DavidMFlynn/RotarySwitch/README.md

# RotarySwitch
 Electronic Rotary Switch
