DavidMFlynn/RotarySwitch/scad/R-SwitchExpanded.png

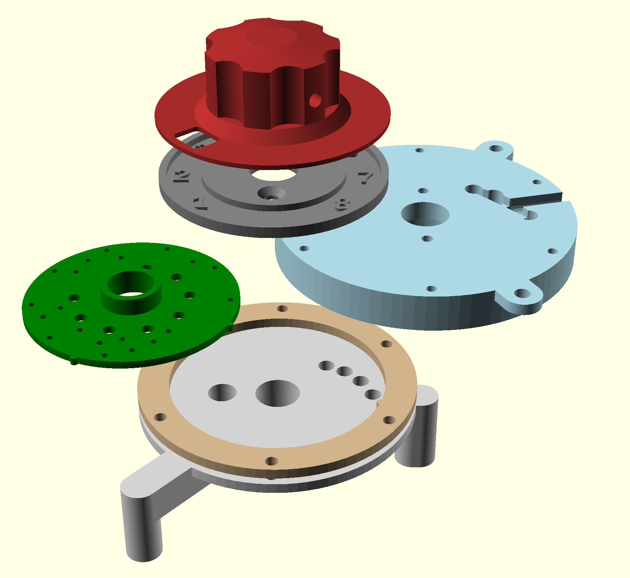
scad/R-SwitchExpanded.png
