DavidMFlynn/RotarySwitch/scad/STL/CW14/RS_Spacer.stl

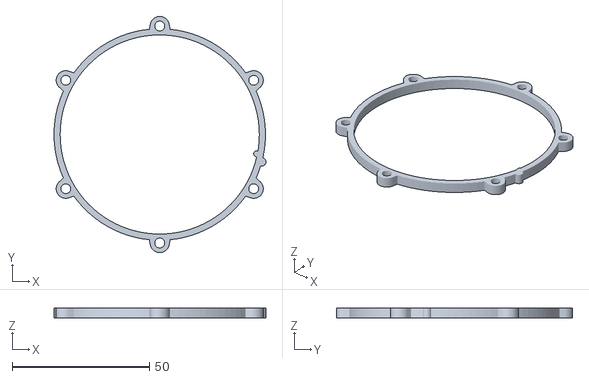
[picture p2: CAD file, 2019-12-07]
scad/STL/CW14/RS_Spacer.stl
77.2 x 86.0 x 3.67
