DavidMFlynn/RotarySwitch/scad/STL/CW16/CW16.stl

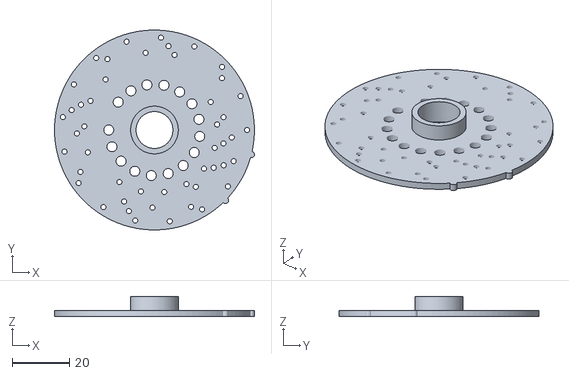
[picture p3: CAD file, 2019-12-07]
scad/STL/CW16/CW16.stl
70.0 x 70.0 x 7.10
