DavidMFlynn/RotarySwitch/scad/STL/n10/CodeWheel.stl

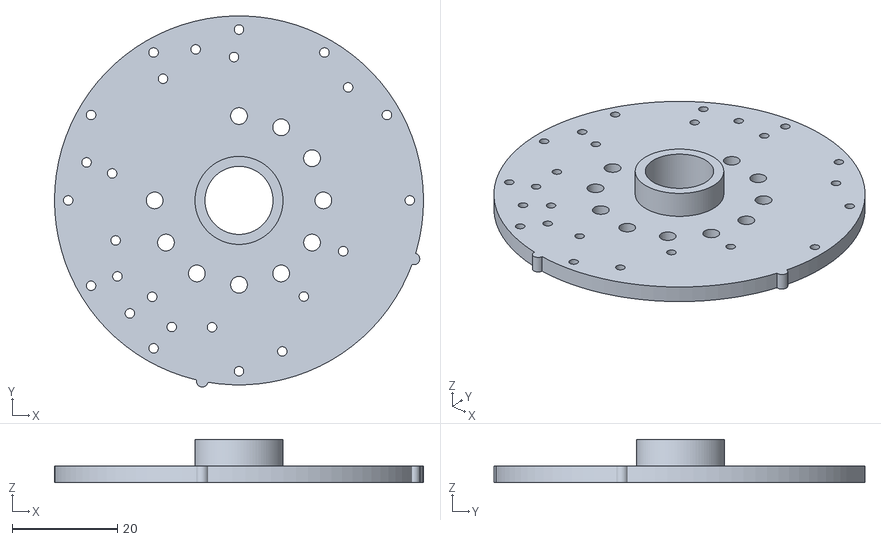
[picture p4: CAD file, 2021-05-18]
scad/STL/n10/CodeWheel.stl
70.0 x 70.4 x 8.17
