DavidMFlynn/RotarySwitch/scad/STL/n4/SpringCover.stl

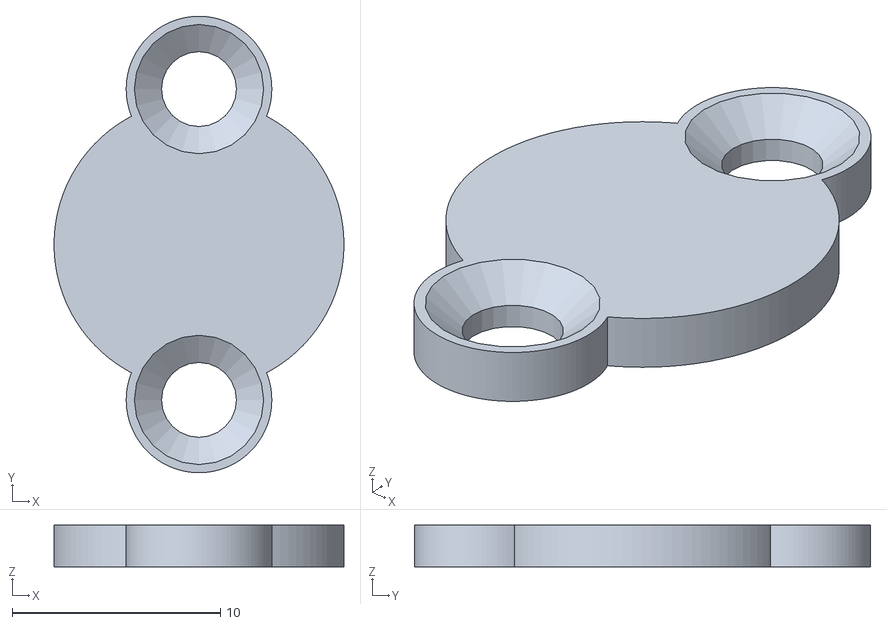
[picture p5: CAD file, 2021-05-18]
scad/STL/n4/SpringCover.stl
13.9 x 21.9 x 2.00
