DavidMFlynn/RotarySwitch/scad/STL/n7/KnobNS.stl

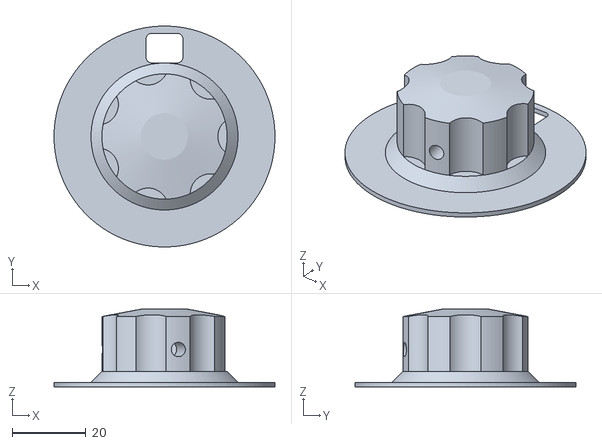
[picture p6: CAD file, 2021-05-18]
scad/STL/n7/KnobNS.stl
60.0 x 60.0 x 21.1
