DavidMFlynn/RotarySwitch/scad/STL/n9/KnobNS.stl

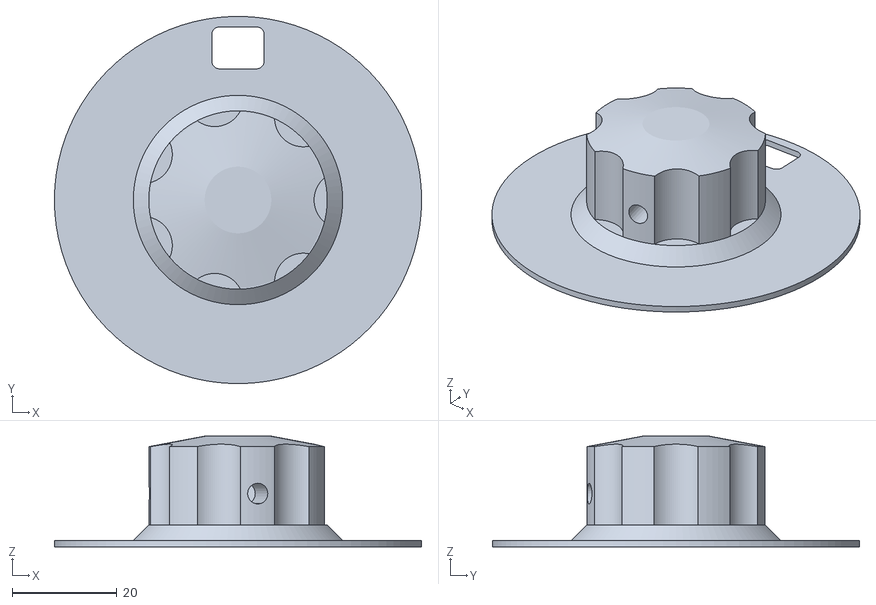
[picture p7: CAD file, 2021-05-18]
scad/STL/n9/KnobNS.stl
70.0 x 70.0 x 21.1
