DavidMFlynn/RotarySwitch/scad/STL/CW16/BotPlate.stl

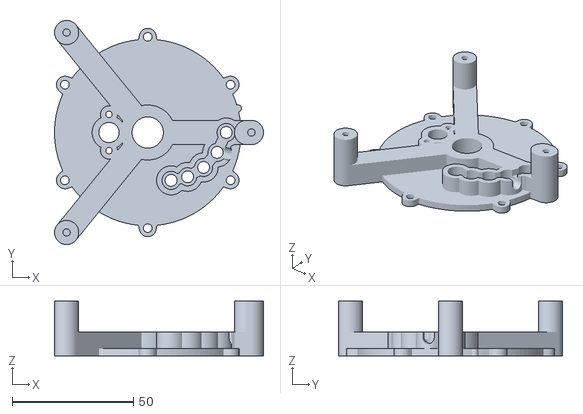
[picture p8: CAD file, 2019-08-11]
scad/STL/CW16/BotPlate.stl
86.3 x 92.5 x 22.7
