DavidMFlynn/RotarySwitch/scad/STL/n10/NumberPlate.stl

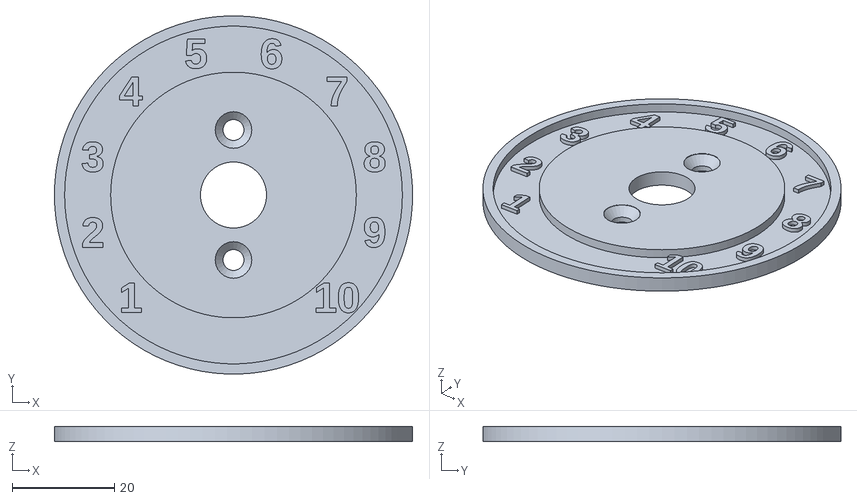
[picture p9: CAD file, 2021-05-18]
scad/STL/n10/NumberPlate.stl
70.0 x 70.0 x 3.00
