DavidMFlynn/RotarySwitch/scad/STL/n4/BotPlate.stl

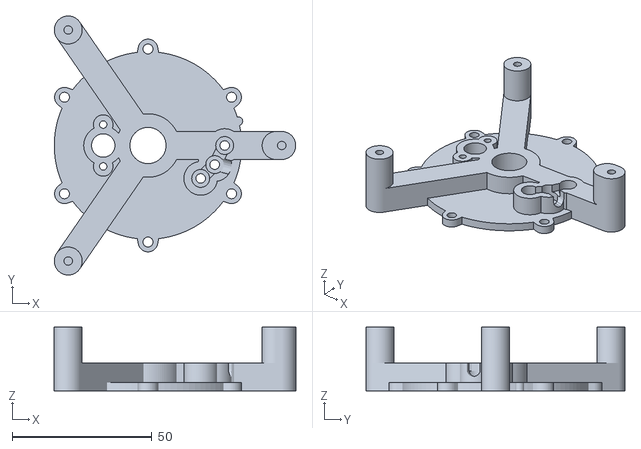
[picture p10: CAD file, 2021-05-18]
scad/STL/n4/BotPlate.stl
86.3 x 92.5 x 22.7
