DavidMFlynn/RotarySwitch/scad/STL/n7/NumberPlate77.stl

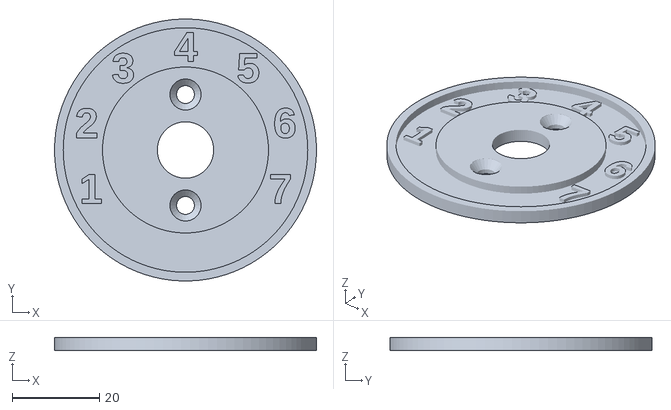
[picture p11: CAD file, 2021-05-18]
scad/STL/n7/NumberPlate77.stl
60.0 x 60.0 x 3.00
