DavidMFlynn/RotarySwitch/scad/STL/n10/TopPlate.stl

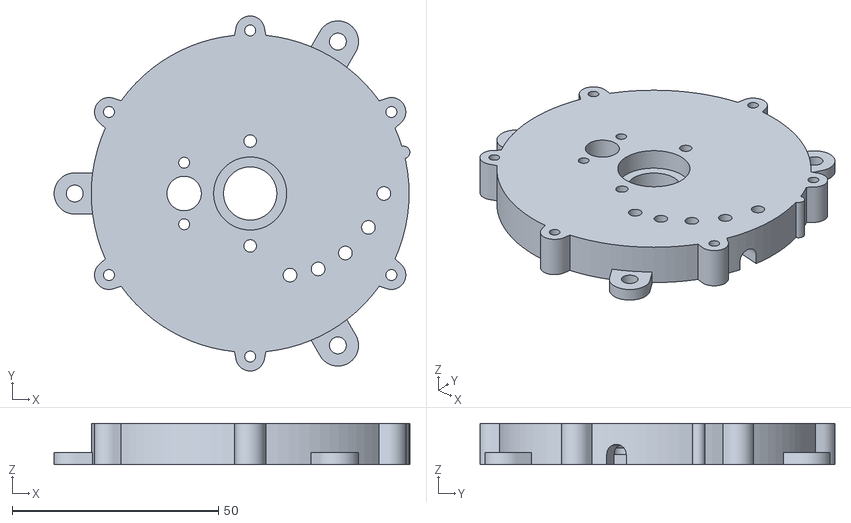
[picture p12: CAD file, 2021-05-18]
scad/STL/n10/TopPlate.stl
86.2 x 86.0 x 10.0
