DavidMFlynn/RotarySwitch/scad/STL/n4/TopPlate.stl

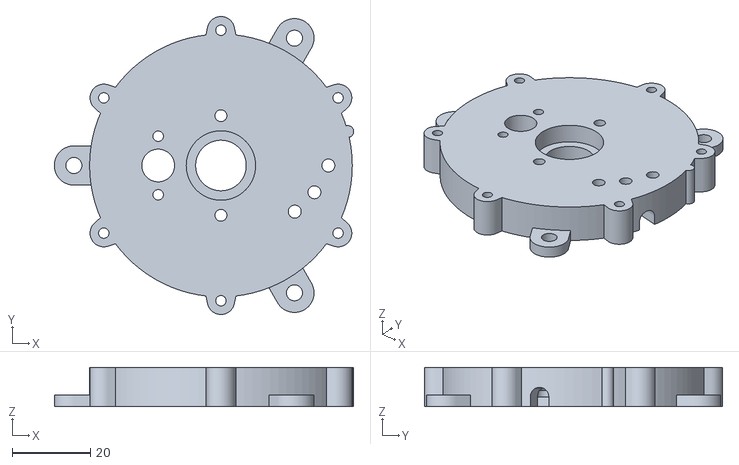
[picture p13: CAD file, 2021-05-18]
scad/STL/n4/TopPlate.stl
76.4 x 76.0 x 10.0
