DavidMFlynn/RotarySwitch/scad/STL/CW14/RS_NP14.stl

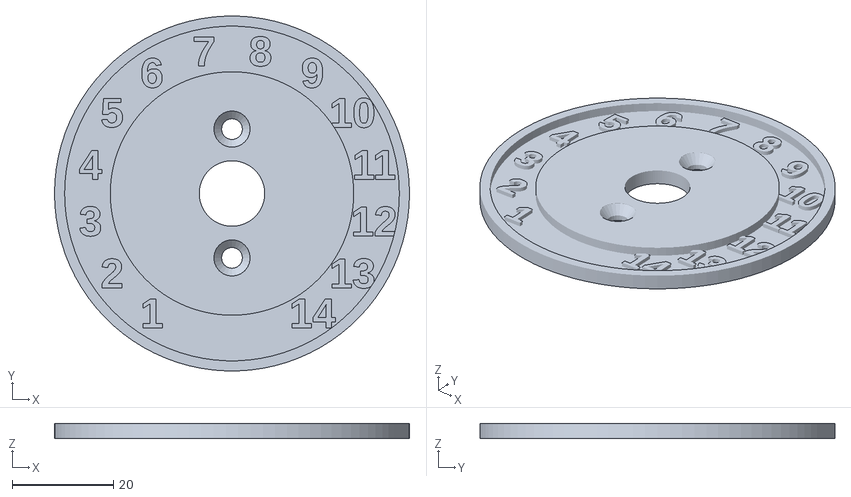
[picture p14: CAD file, 2019-08-07]
scad/STL/CW14/RS_NP14.stl
70.0 x 70.0 x 3.00
