DavidMFlynn/RotarySwitch/scad/STL/n4/NumberPlate.stl

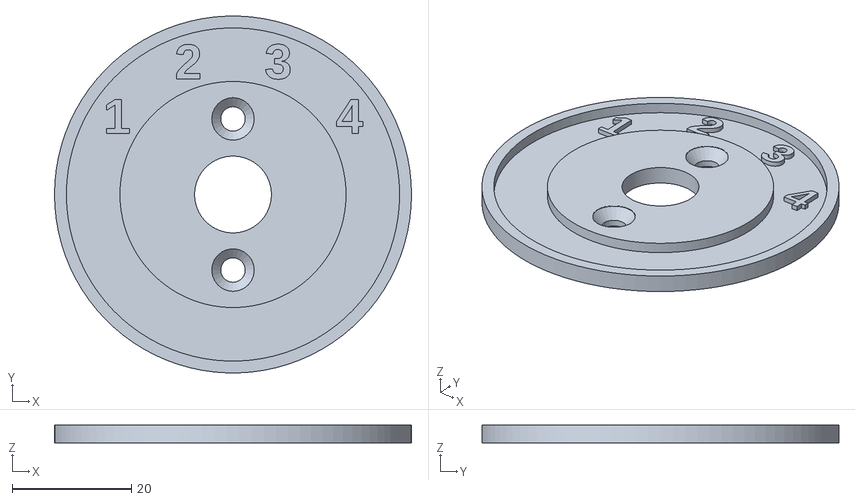
[picture p15: CAD file, 2021-05-18]
scad/STL/n4/NumberPlate.stl
60.0 x 60.0 x 3.00
