DavidMFlynn/RotarySwitch/scad/STL/n4/CodeWheel.stl

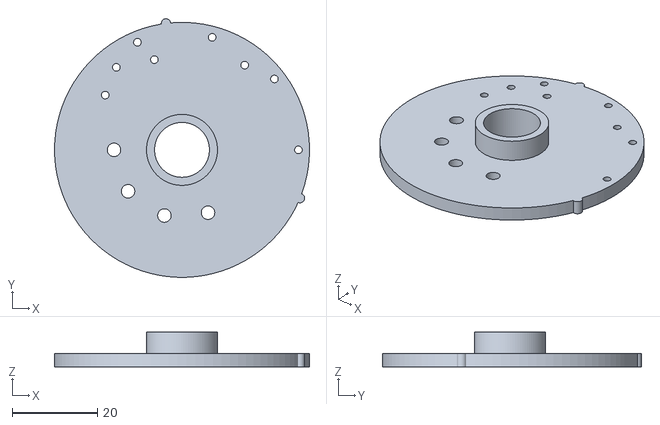
[picture p16: CAD file, 2021-05-18]
scad/STL/n4/CodeWheel.stl
60.0 x 60.8 x 8.17
