DavidMFlynn/RotarySwitch/scad/STL/CW16/NumberPlate.stl

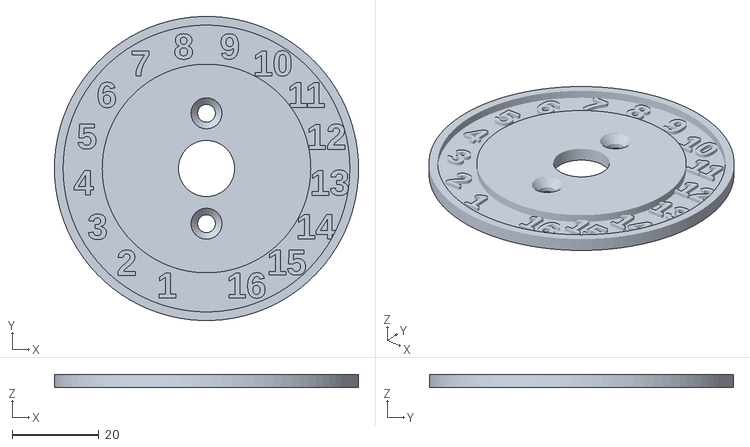
[picture p17: CAD file, 2019-08-11]
scad/STL/CW16/NumberPlate.stl
70.0 x 70.0 x 3.00
