DavidMFlynn/RotarySwitch/scad/STL/n7/CodeWheel.stl

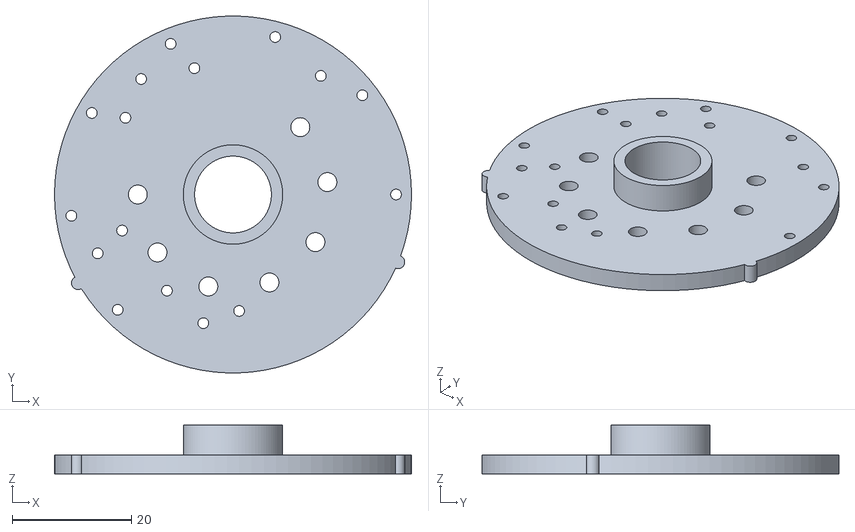
[picture p18: CAD file, 2021-05-11]
scad/STL/n7/CodeWheel.stl
60.0 x 60.0 x 8.17
