DavidMFlynn/RotarySwitch/scad/STL/CW16/SpacerRing.stl

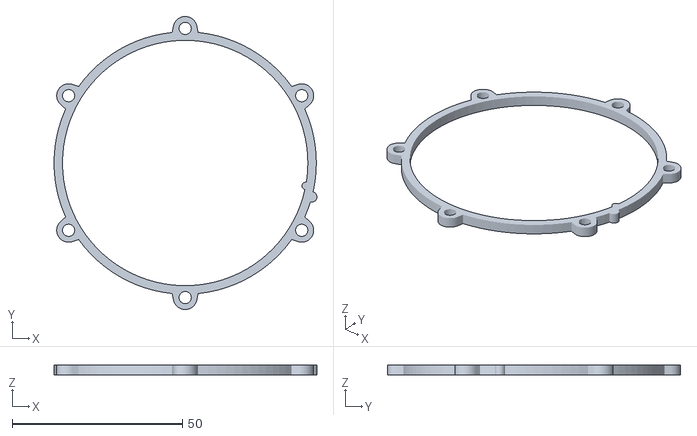
[picture p19: CAD file, 2019-08-11]
scad/STL/CW16/SpacerRing.stl
77.2 x 86.0 x 3.00
