DavidMFlynn/RotarySwitch/scad/STL/n4/SpacerRing.stl

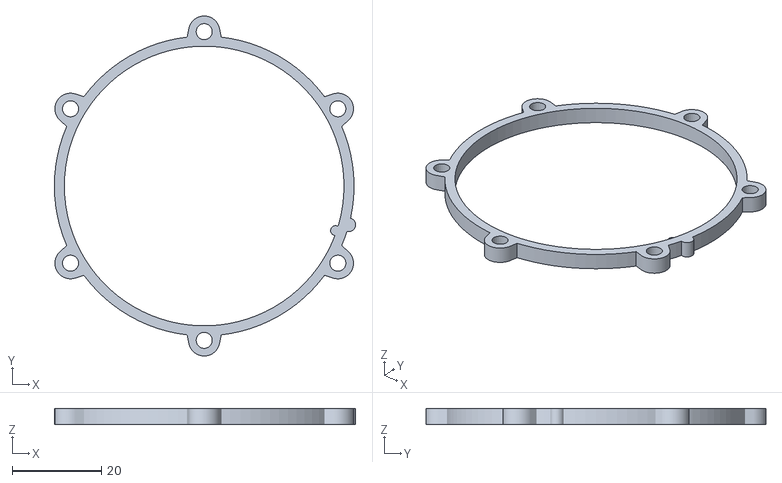
[picture p20: CAD file, 2021-05-18]
scad/STL/n4/SpacerRing.stl
67.4 x 76.0 x 3.67
