DavidMFlynn/RotarySwitch/(list of files, cad)

Other CAD files:
scad/STL/CW14/RS_CW14.stl
scad/STL/n9/Spacer.stl
scad/STL/CW14/RS_Bot.stl
scad/STL/CW16/Knob.stl
scad/STL/n7/DetentCover.stl
scad/STL/n9/DetentCover.stl
scad/STL/CW16/TopPlate.stl
scad/STL/n10/BotPlate.stl
scad/STL/n7/NumberPlate.stl
scad/STL/n9/Knob.stl
scad/STL/CW14/RS_Knob.stl
scad/STL/CW16/DetentCover.stl
scad/STL/n10/KnobNS.stl
scad/STL/n7/BotPlate.stl
scad/STL/n9/TopPlate.stl
scad/STL/CW14/RS_Top.stl
scad/STL/n10/SpacerRing.stl
scad/STL/n9/BotPlate.stl
scad/STL/CW14/RS_Retainer.stl
scad/STL/n7/Knob.stl
scad/STL/n9/NumberPlate.stl
scad/STL/n7/SpacerRing.stl
scad/STL/n9/CodeWheel.stl
scad/STL/n7/TopPlate.stl
