DavidMFlynn/RotarySwitch/R_Switch Rev B/R_Switch.sch.pdf

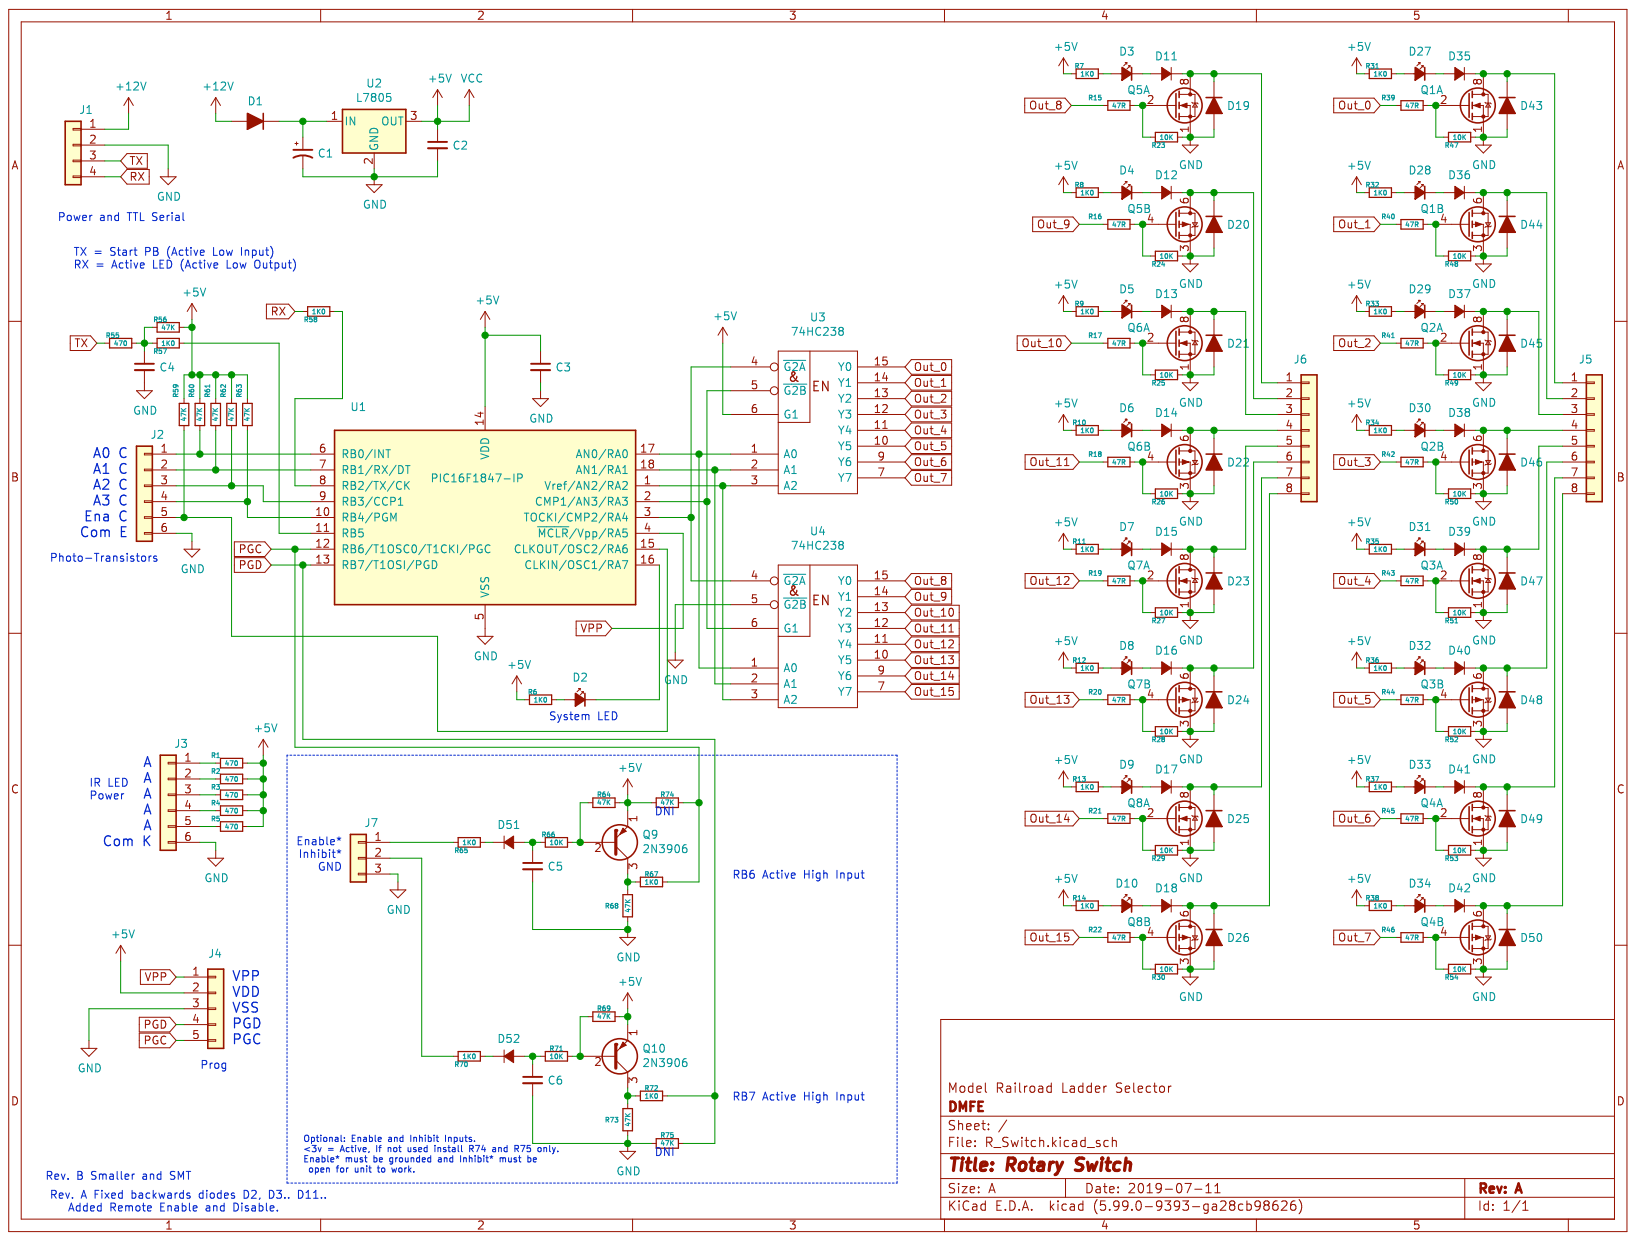
[picture p21: page 1]
