DavidMFlynn/RotarySwitch/R_Switch Rev A/R_Switch.sch.pdf

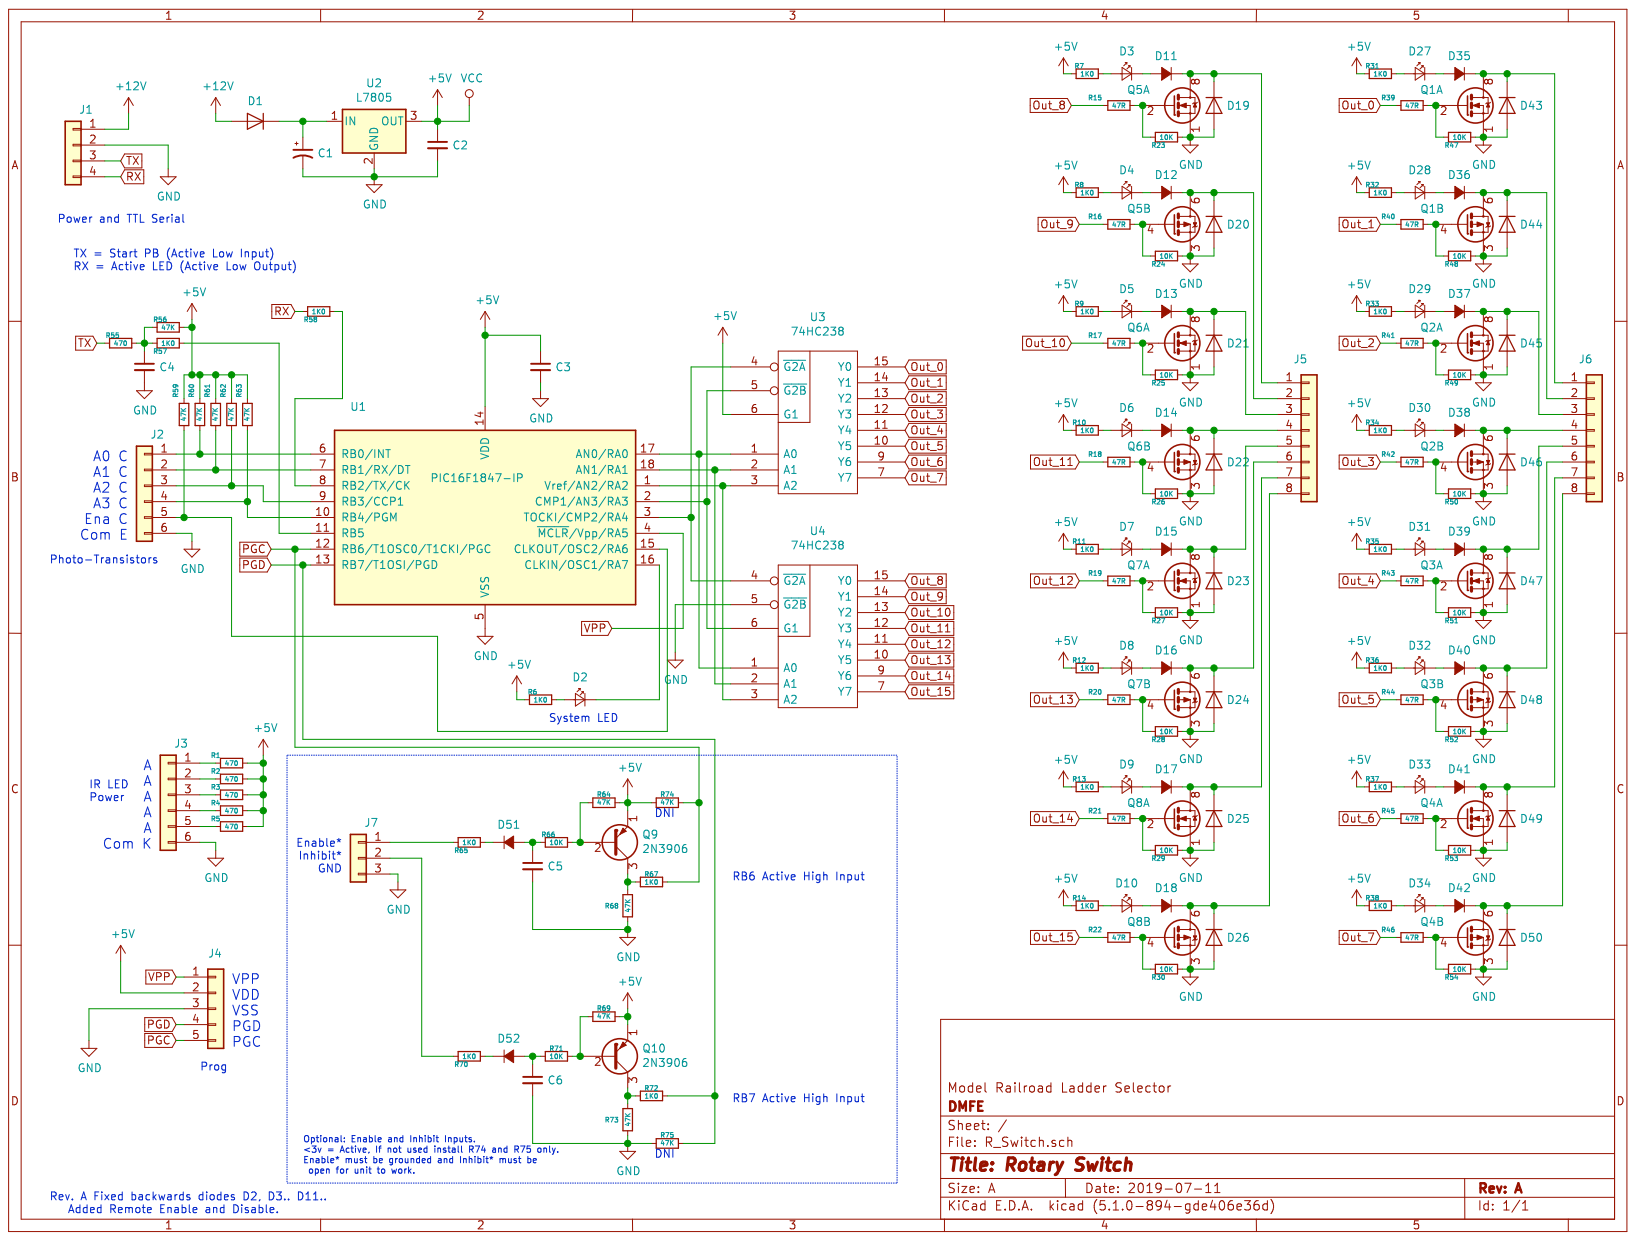
[picture p28: page 1]
