DavidMFlynn/RotarySwitch/R_Switch Rev A/R_Switch.schBW.pdf

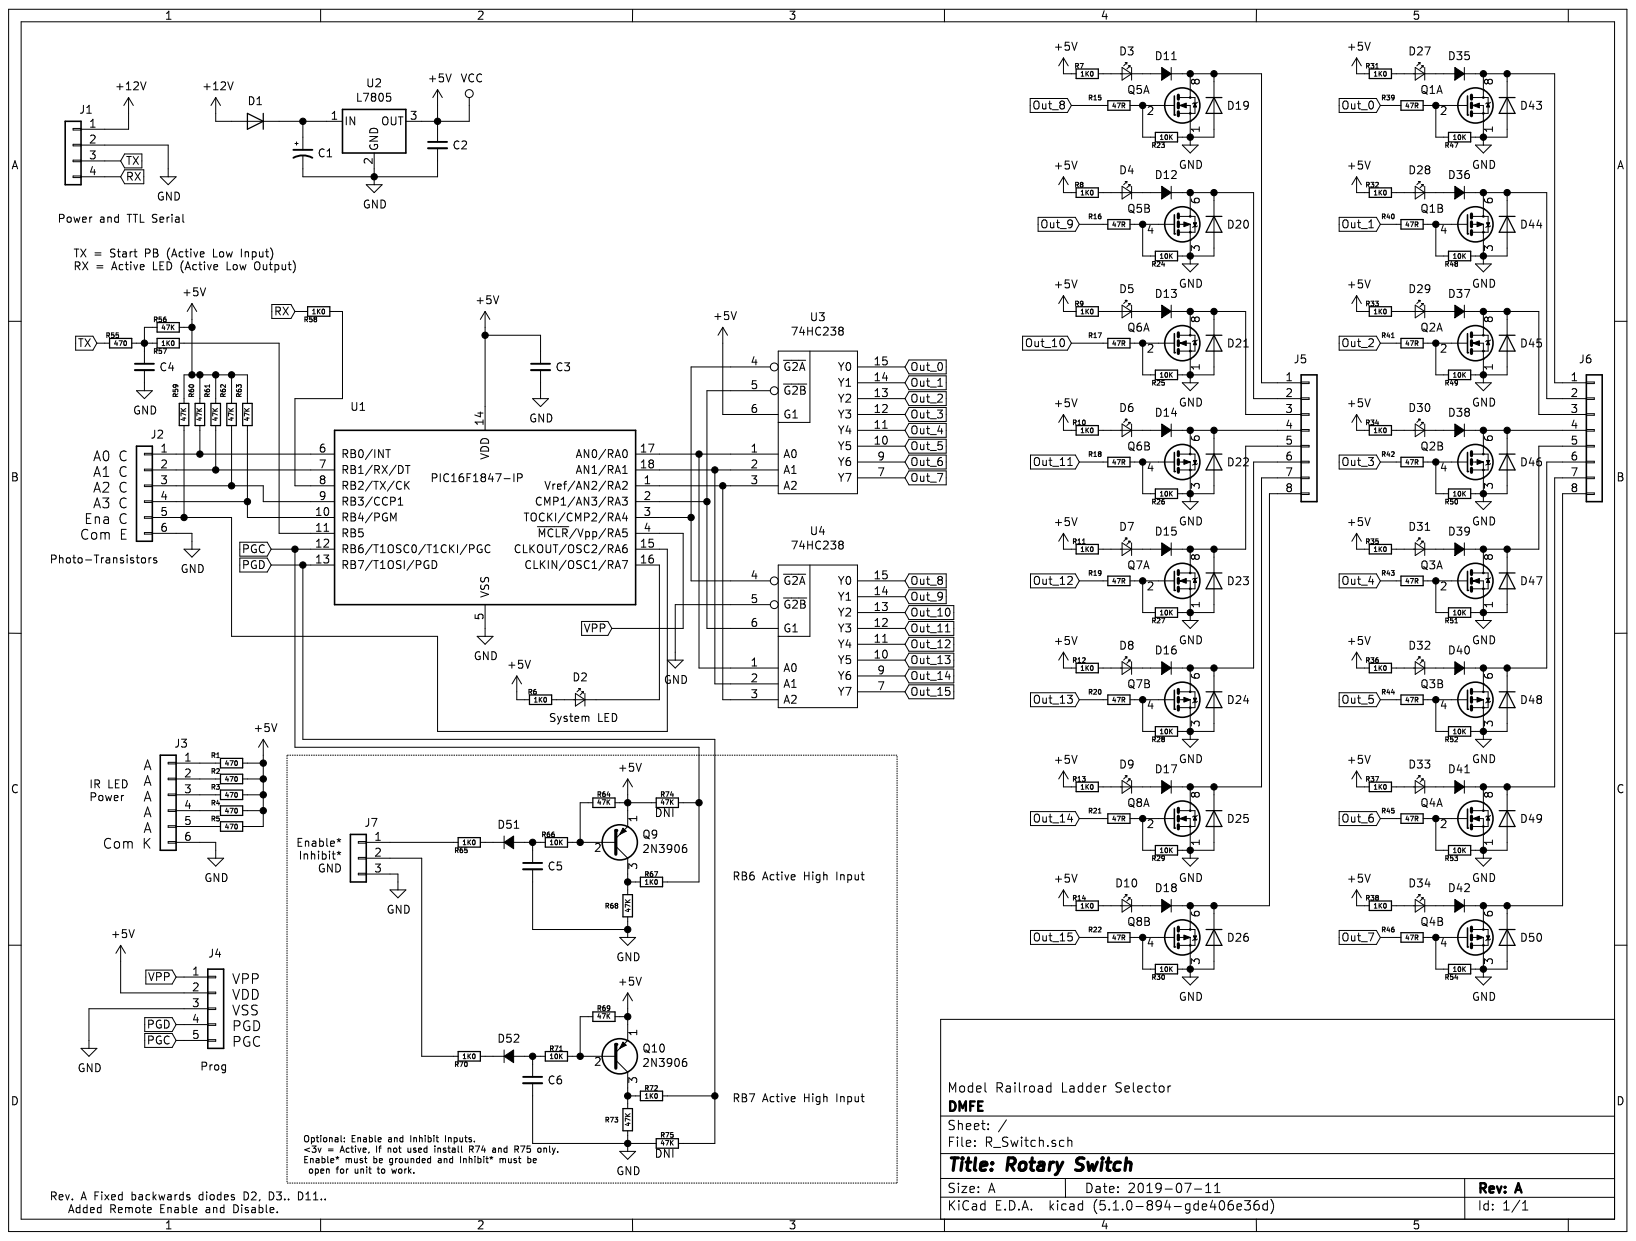
[picture p29: page 1]
