DavidMFlynn/RotarySwitch/R_Switch/R_Switch.sch.pdf

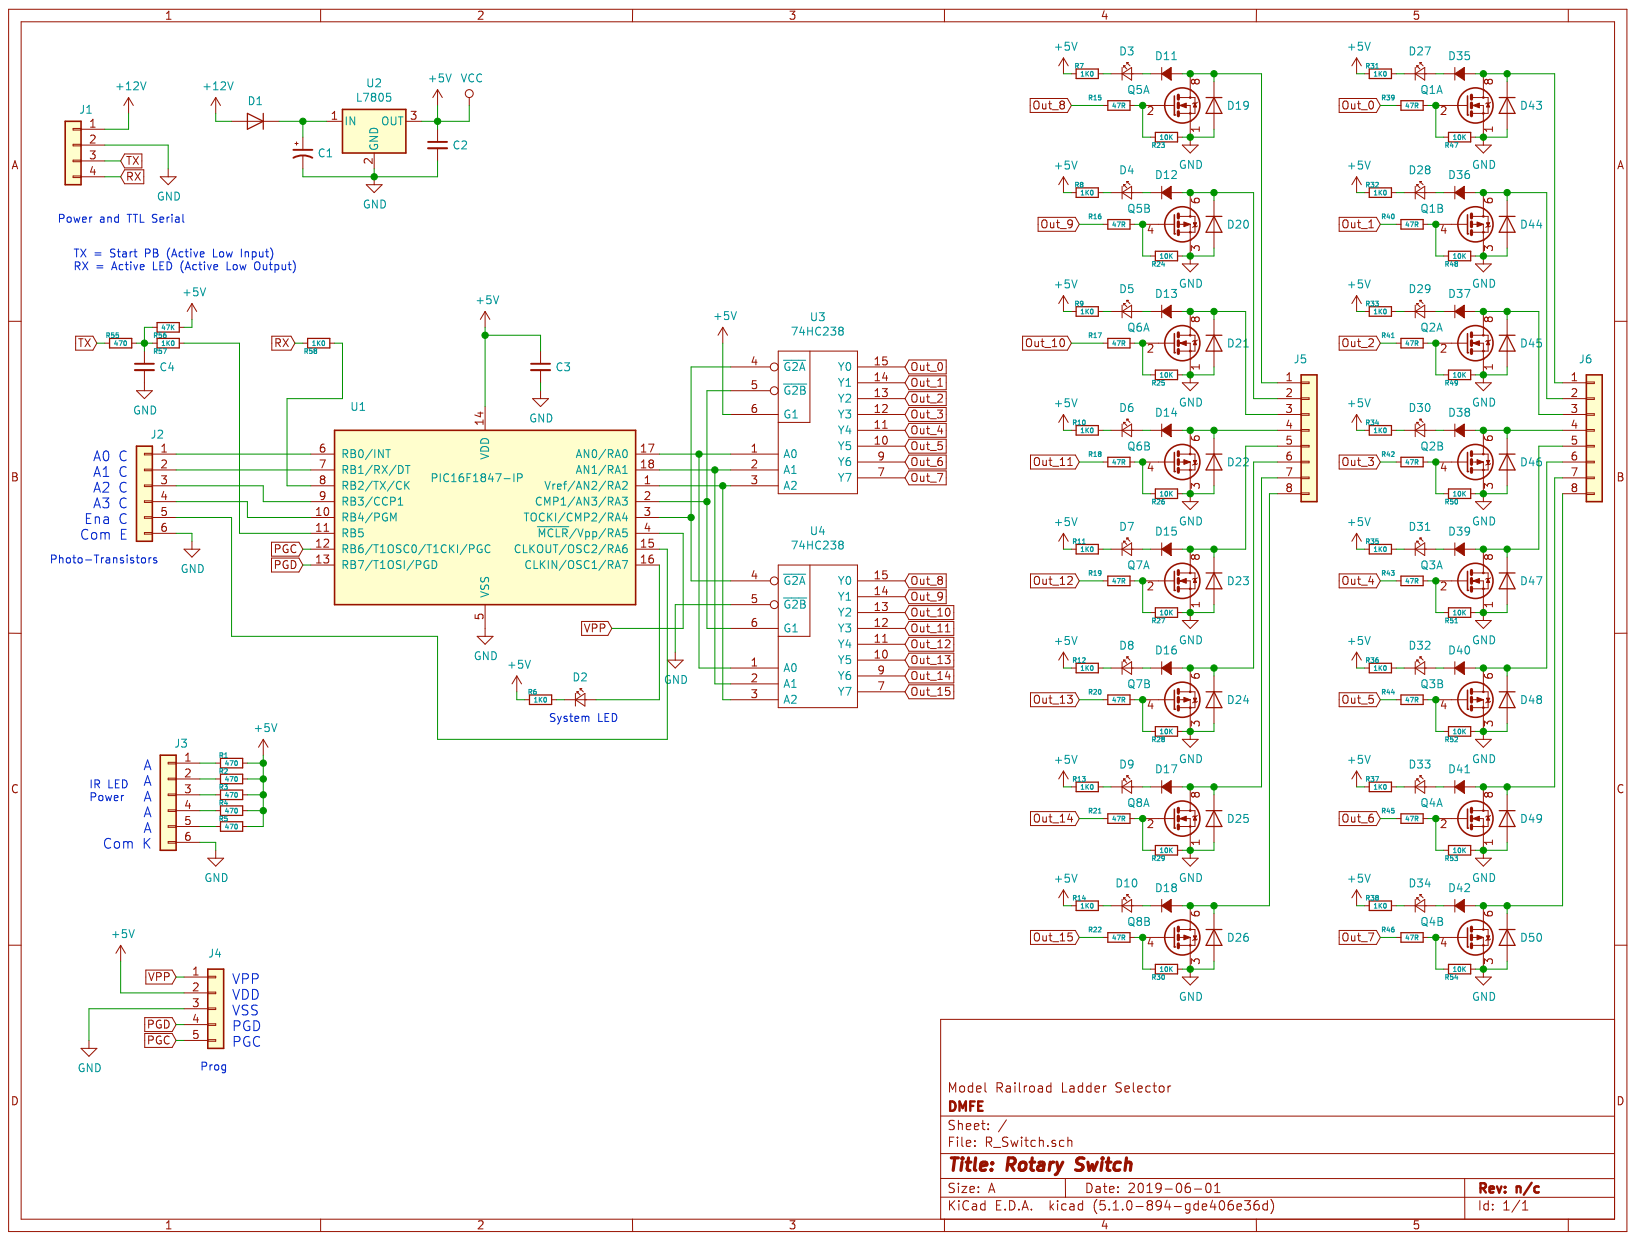
[picture p30: page 1]
