DavidMFlynn/RotarySwitch/R_Switch/R_Switch.schBW.pdf

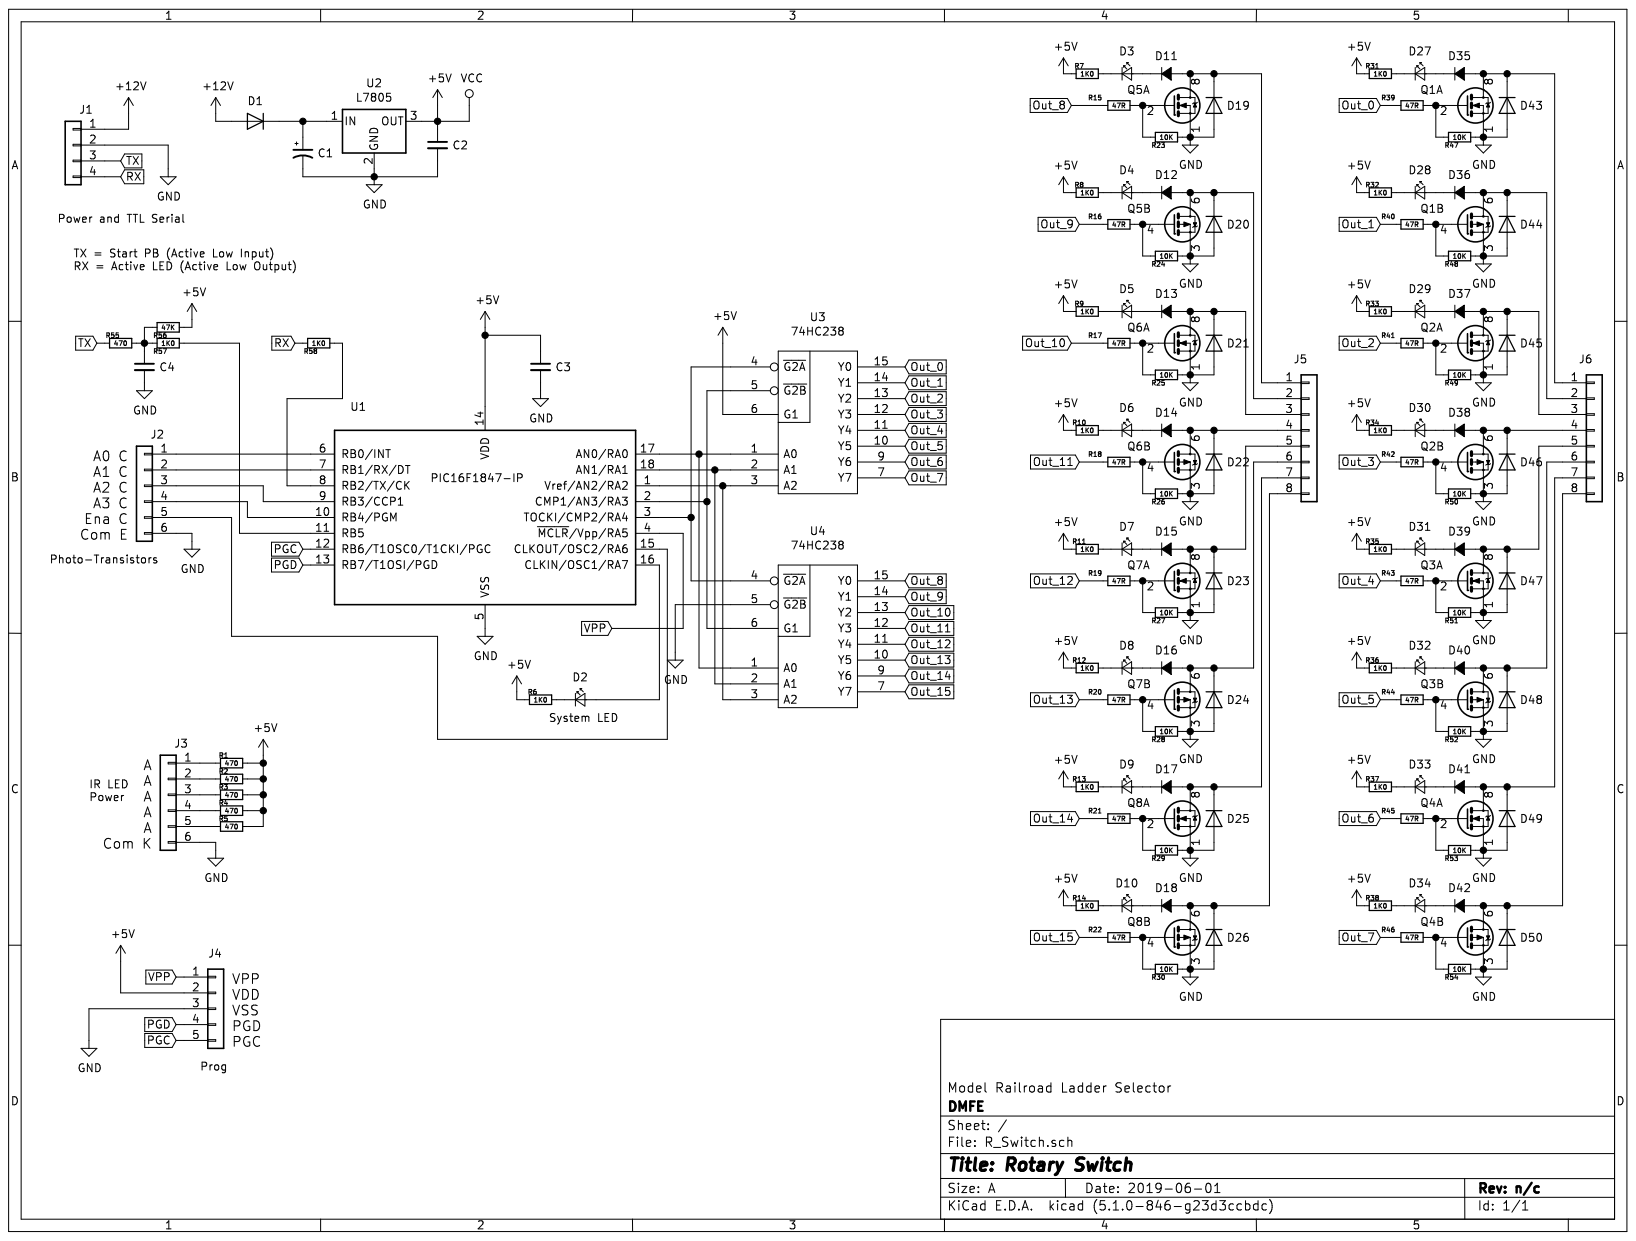
[picture p31: page 1]
