DavidMFlynn/RotarySwitch/R_Switch Rev B/R_Switch.kicad_pcb

## KiCad design R_Switch Rev B/R_Switch.kicad_pcb (2021-05-07)

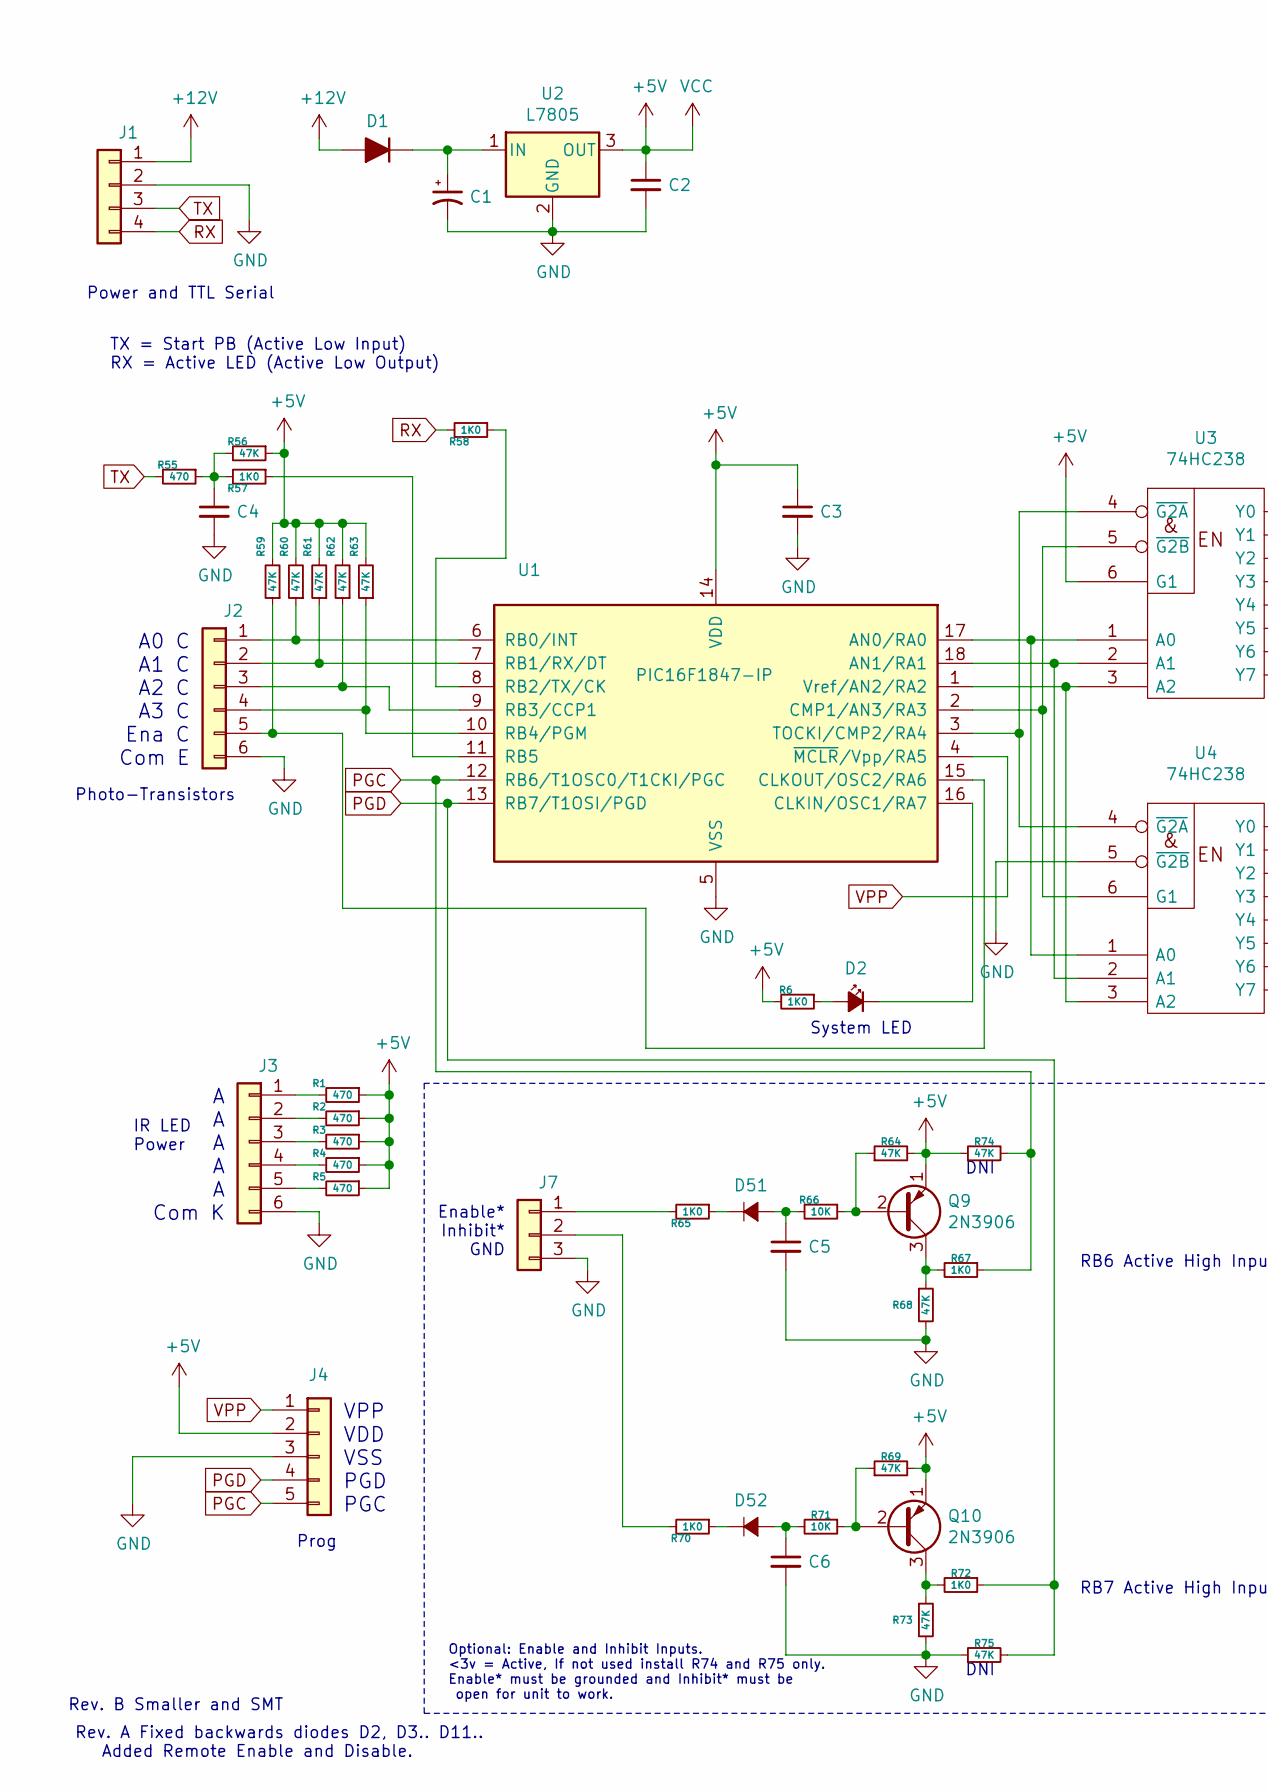
[picture p32: schematic R_Switch.kicad_sch, Rotary Switch, part in row 1, column 1]

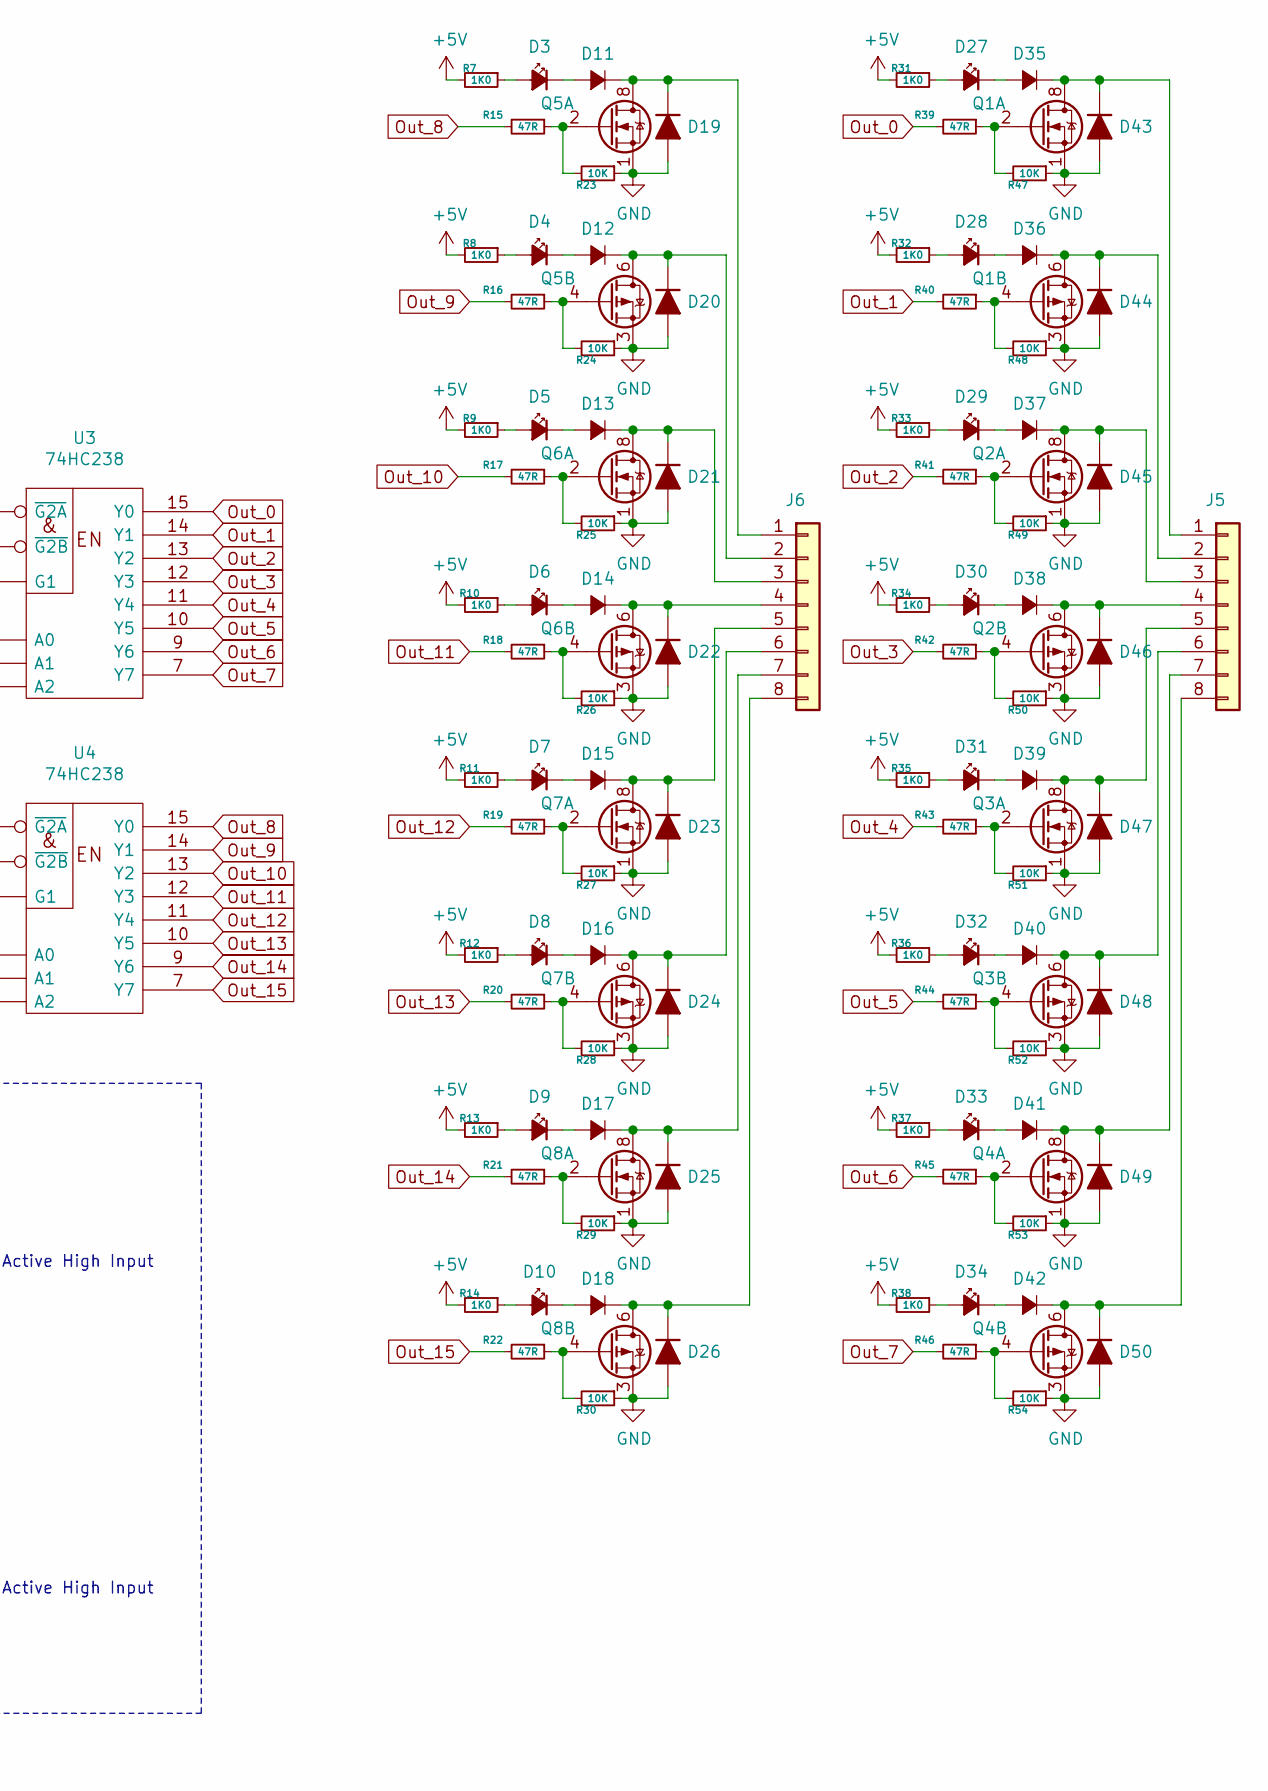
[picture p33: schematic R_Switch.kicad_sch, Rotary Switch, part in row 1, column 2]

Parts:
C1: 4.7; CP_Radial_D5.0mm_P2.50mm
C2, C3, C4, C5, C6: 0.1; C_0805_2012Metric_Pad1.18x1.45mm_HandSolder
D1, D19, D20, D21, D22, D23, D24, D25, D26, D43, D44, D45, D46, D47, D48, D49, D50: D; D_SMA_Handsoldering
D2, D3, D4, D5, D6, D7, D8, D9, D10, D27, D28, D29, D30, D31, D32, D33, D34: LED_Small; LED_1206_3216Metric_Pad1.42x1.75mm_HandSolder
D11, D12, D13, D14, D15, D16, D17, D18, D35, D36, D37, D38, D39, D40, D41, D42, D51, D52: D_Small_ALT; D_SOD-123
J1: Conn_01x04; PhoenixContact_MSTBVA_2,5_4-G-5,08_1x04_P5.08mm_Vertical
J2, J3: Conn_01x06; PinHeader_1x06_P2.54mm_Vertical
J4: Conn_01x05; PinHeader_1x05_P2.54mm_Vertical
J5, J6: Conn_01x08; PhoenixContact_MSTBVA_2,5_8-G-5,08_1x08_P5.08mm_Vertical
J7: Conn_01x03; PhoenixContact_MSTBVA_2,5_3-G-5,08_1x03_P5.08mm_Vertical
Q1, Q2, Q3, Q4, Q5, Q6, Q7, Q8: IRF7343PBF; SOIC-8_3.9x4.9mm_P1.27mm
Q9, Q10: 2N3906; TO-92_Inline
R1, R2, R3, R4, R5, R55: 470; R_0805_2012Metric_Pad1.20x1.40mm_HandSolder
R6, R7, R8, R9, R10, R11, R12, R13, R14, R31, R32, R33, R34, R35, R36, R37, R38, R57, R58, R65, R67, R70, R72: 1K0; R_0805_2012Metric_Pad1.20x1.40mm_HandSolder
R15, R16, R17, R18, R19, R20, R21, R22, R39, R40, R41, R42, R43, R44, R45, R46: 47R; R_0805_2012Metric_Pad1.20x1.40mm_HandSolder
R23, R24, R25, R26, R27, R28, R29, R30, R47, R48, R49, R50, R51, R52, R53, R54, R66, R71: 10K; R_0805_2012Metric_Pad1.20x1.40mm_HandSolder
R56, R59, R60, R61, R62, R63, R64, R68, R69, R73, R74, R75: 47K; R_0805_2012Metric_Pad1.20x1.40mm_HandSolder
U1: PIC16F1847-IP; SOIC-18W_7.5x11.6mm_P1.27mm
U2: L7805; TO-252-2
U3, U4: 74HC238; SOP-16_3.9x9.9mm_P1.27mm

Connections:
+5V: C2.1, C3.1, J4.2, Q9.1 (E), Q10.1 (E), R1.1, R2.1, R3.1, R4.1, R5.1, R6.2, R7.2, R8.2, R9.2, R10.2, R11.2, R12.2, R13.2, R14.2, R31.2, R32.2, R33.2, R34.2, R35.2, R36.2, R37.2, R38.2, R56.1, R59.2, R60.2, R61.2, R62.2, R63.2, R64.2, R69.2, R74.1, U1.14 (VDD), U2.3 (OUT), U3.6 (G1), U3.16 (VCC), U4.16 (VCC)
+12V: D1.2 (A), J1.1
GND: C1.2, C2.2, C3.2, C4.2, C5.2, C6.2, D19.2 (A), D20.2 (A), D21.2 (A), D22.2 (A), D23.2 (A), D24.2 (A), D25.2 (A), D26.2 (A), D43.2 (A), D44.2 (A), D45.2 (A), D46.2 (A), D47.2 (A), D48.2 (A), D49.2 (A), D50.2 (A), J1.2, J2.6, J3.6, J4.3, J7.3, Q1.1 (S), Q1.3 (1), Q2.1 (S), Q2.3 (1), Q3.1 (S), Q3.3 (1), Q4.1 (S), Q4.3 (1), Q5.1 (S), Q5.3 (1), Q6.1 (S), Q6.3 (1), Q7.1 (S), Q7.3 (1), Q8.1 (S), Q8.3 (1), R23.1, R24.1, R25.1, R26.1, R27.1, R28.1, R29.1, R30.1, R47.1, R48.1, R49.1, R50.1, R51.1, R52.1, R53.1, R54.1, R68.2, R73.2, R75.1, U1.5 (VSS), U2.2 (GND), U3.8 (GND), U4.5 (~G2B), U4.8 (GND)
unnamed: C1.1, D1.1 (K), U2.1 (IN)
unnamed: C4.1, R55.1, R56.2, R57.2
unnamed: C5.1, D51.2 (A), R66.2
unnamed: C6.1, D52.2 (A), R71.2
unnamed: D2.1 (K), U1.16 (CLKIN/OSC1/RA7)
unnamed: D2.2 (A), R6.1
unnamed: D3.2 (A), R7.1
unnamed: D4.2 (A), R8.1
unnamed: D5.2 (A), R9.1
unnamed: D6.2 (A), R10.1
unnamed: D7.2 (A), R11.1
unnamed: D8.2 (A), R12.1
unnamed: D9.2 (A), R13.1
unnamed: D10.1 (K), D18.2 (A)
unnamed: D10.2 (A), R14.1
unnamed: D11.1 (K), D19.1 (K), J6.1, Q5.7 (D), Q5.8 (D)
unnamed: D3.1 (K), D11.2 (A)
unnamed: D12.1 (K), D20.1 (K), J6.2, Q5.5 (D), Q5.6 (D)
unnamed: D4.1 (K), D12.2 (A)
unnamed: D13.1 (K), D21.1 (K), J6.3, Q6.7 (D), Q6.8 (D)
unnamed: D5.1 (K), D13.2 (A)
unnamed: D14.1 (K), D22.1 (K), J6.4, Q6.5 (D), Q6.6 (D)
unnamed: D6.1 (K), D14.2 (A)
unnamed: D15.1 (K), D23.1 (K), J6.5, Q7.7 (D), Q7.8 (D)
unnamed: D7.1 (K), D15.2 (A)
unnamed: D16.1 (K), D24.1 (K), J6.6, Q7.5 (D), Q7.6 (D)
unnamed: D8.1 (K), D16.2 (A)
unnamed: D17.1 (K), D25.1 (K), J6.7, Q8.7 (D), Q8.8 (D)
unnamed: D9.1 (K), D17.2 (A)
unnamed: D18.1 (K), D26.1 (K), J6.8, Q8.5 (D), Q8.6 (D)
unnamed: D27.1 (K), D35.2 (A)
unnamed: D27.2 (A), R31.1
unnamed: D28.1 (K), D36.2 (A)
unnamed: D28.2 (A), R32.1
unnamed: D29.1 (K), D37.2 (A)
unnamed: D29.2 (A), R33.1
unnamed: D30.1 (K), D38.2 (A)
unnamed: D30.2 (A), R34.1
unnamed: D31.1 (K), D39.2 (A)
unnamed: D31.2 (A), R35.1
unnamed: D32.1 (K), D40.2 (A)
unnamed: D32.2 (A), R36.1
unnamed: D33.1 (K), D41.2 (A)
unnamed: D33.2 (A), R37.1
unnamed: D34.1 (K), D42.2 (A)
unnamed: D34.2 (A), R38.1
unnamed: D35.1 (K), D43.1 (K), J5.1, Q1.7 (D), Q1.8 (D)
unnamed: D36.1 (K), D44.1 (K), J5.2, Q1.5 (D), Q1.6 (D)
unnamed: D37.1 (K), D45.1 (K), J5.3, Q2.7 (D), Q2.8 (D)
unnamed: D38.1 (K), D46.1 (K), J5.4, Q2.5 (D), Q2.6 (D)
unnamed: D39.1 (K), D47.1 (K), J5.5, Q3.7 (D), Q3.8 (D)
unnamed: D40.1 (K), D48.1 (K), J5.6, Q3.5 (D), Q3.6 (D)
unnamed: D41.1 (K), D49.1 (K), J5.7, Q4.7 (D), Q4.8 (D)
unnamed: D42.1 (K), D50.1 (K), J5.8, Q4.5 (D), Q4.6 (D)
unnamed: D51.1 (K), R65.1
unnamed: D52.1 (K), R70.1
unnamed: J2.1, R60.1, U1.6 (RB0/INT)
unnamed: J2.2, R61.1, U1.7 (RB1/RX/DT)
unnamed: J2.3, R62.1, U1.9 (RB3/CCP1)
unnamed: J2.4, R63.1, U1.10 (RB4/PGM)
unnamed: J2.5, R59.1, U1.15 (CLKOUT/OSC2/RA6)
unnamed: J3.1, R1.2
unnamed: J3.2, R2.2
unnamed: J3.3, R3.2
unnamed: J3.4, R4.2
unnamed: J3.5, R5.2
unnamed: J7.1, R65.2
unnamed: J7.2, R70.2
unnamed: Q1.2 (G), R39.1, R47.2
unnamed: Q1.4 (G), R40.1, R48.2
unnamed: Q2.2 (G), R41.1, R49.2
unnamed: Q2.4 (G), R42.1, R50.2
unnamed: Q3.2 (G), R43.1, R51.2
unnamed: Q3.4 (G), R44.1, R52.2
unnamed: Q4.2 (G), R45.1, R53.2
unnamed: Q4.4 (G), R46.1, R54.2
unnamed: Q5.2 (G), R15.1, R23.2
unnamed: Q5.4 (G), R16.1, R24.2
unnamed: Q6.2 (G), R17.1, R25.2
unnamed: Q6.4 (G), R18.1, R26.2
unnamed: Q7.2 (G), R19.1, R27.2
unnamed: Q7.4 (G), R20.1, R28.2
unnamed: Q8.2 (G), R21.1, R29.2
unnamed: Q8.4 (G), R22.1, R30.2
unnamed: Q9.2 (B), R64.1, R66.1
unnamed: Q9.3 (C), R67.2, R68.1
unnamed: Q10.2 (B), R69.1, R71.1
unnamed: Q10.3 (C), R72.2, R73.1
unnamed: R57.1, U1.11 (RB5)
unnamed: R58.1, U1.8 (RB2/TX/CK)
unnamed: U1.1 (Vref/AN2/RA2), U3.3 (A2), U4.3 (A2)
unnamed: U1.2 (CMP1/AN3/RA3), U3.5 (~G2B), U4.6 (G1)
unnamed: U1.3 (TOCKI/CMP2/RA4), U3.4 (~G2A), U4.4 (~G2A)
unnamed: U1.17 (AN0/RA0), U3.1 (A0), U4.1 (A0)
unnamed: U1.18 (AN1/RA1), U3.2 (A1), U4.2 (A1)
Out_0: R39.2, U3.15 (Y0)
Out_1: R40.2, U3.14 (Y1)
Out_2: R41.2, U3.13 (Y2)
Out_3: R42.2, U3.12 (Y3)
Out_4: R43.2, U3.11 (Y4)
Out_5: R44.2, U3.10 (Y5)
Out_6: R45.2, U3.9 (Y6)
Out_7: R46.2, U3.7 (Y7)
Out_8: R15.2, U4.15 (Y0)
Out_9: R16.2, U4.14 (Y1)
Out_10: R17.2, U4.13 (Y2)
Out_11: R18.2, U4.12 (Y3)
Out_12: R19.2, U4.11 (Y4)
Out_13: R20.2, U4.10 (Y5)
Out_14: R21.2, U4.9 (Y6)
Out_15: R22.2, U4.7 (Y7)
PGC: J4.5, R67.1, R74.2, U1.12 (RB6/T1OSC0/T1CKI/PGC)
PGD: J4.4, R72.1, R75.2, U1.13 (RB7/T1OSI/PGD)
RX: J1.4, R58.2
TX: J1.3, R55.2
VPP: J4.1, U1.4 (~MCLR~/Vpp/RA5)

Notes on the sheet:
Photo-Transistors
Rev. A Fixed backwards diodes D2, D3.. D11.. Added Remote Enable and Disable.
Power and TTL Serial
TX = Start PB (Active Low Input) RX = Active LED (Active Low Output)
IR LED Power
A0 C A1 C A2 C A3 C Ena C Com E
A A A A A Com K
Rev. B Smaller and SMT
Prog
VPP VDD VSS PGD PGC
Optional: Enable and Inhibit Inputs. <3v = Active, If not used install R74 and R75 only. Enable* must be grounded and Inhibit* must be open for unit to work.
Enable* Inhibit* GND
System LED
DNI
RB6 Active High Input
RB7 Active High Input

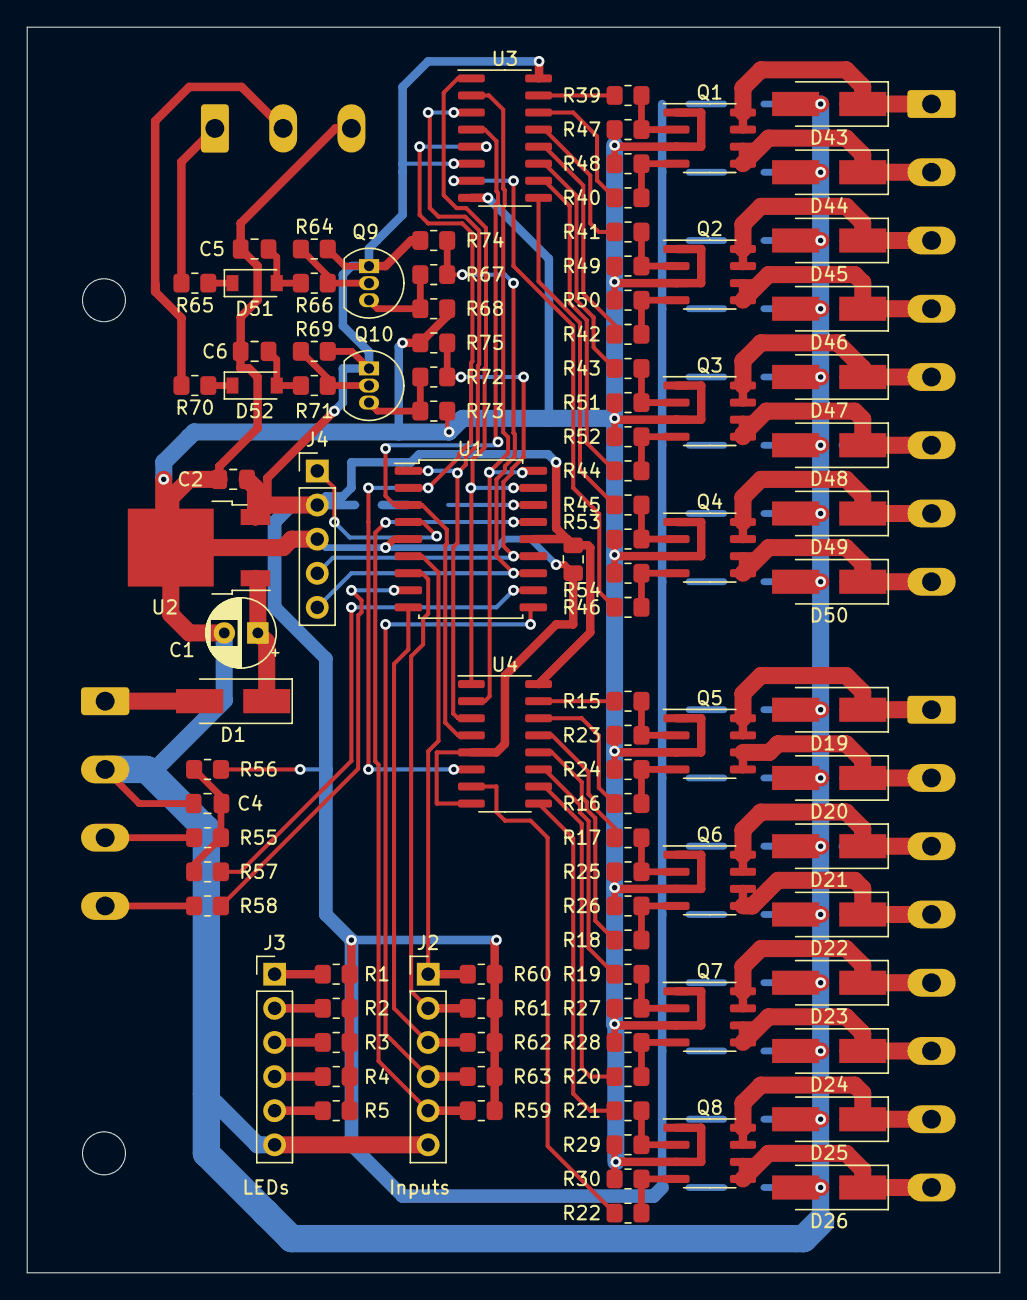
[picture p34: board R_Switch.kicad_pcb from above]

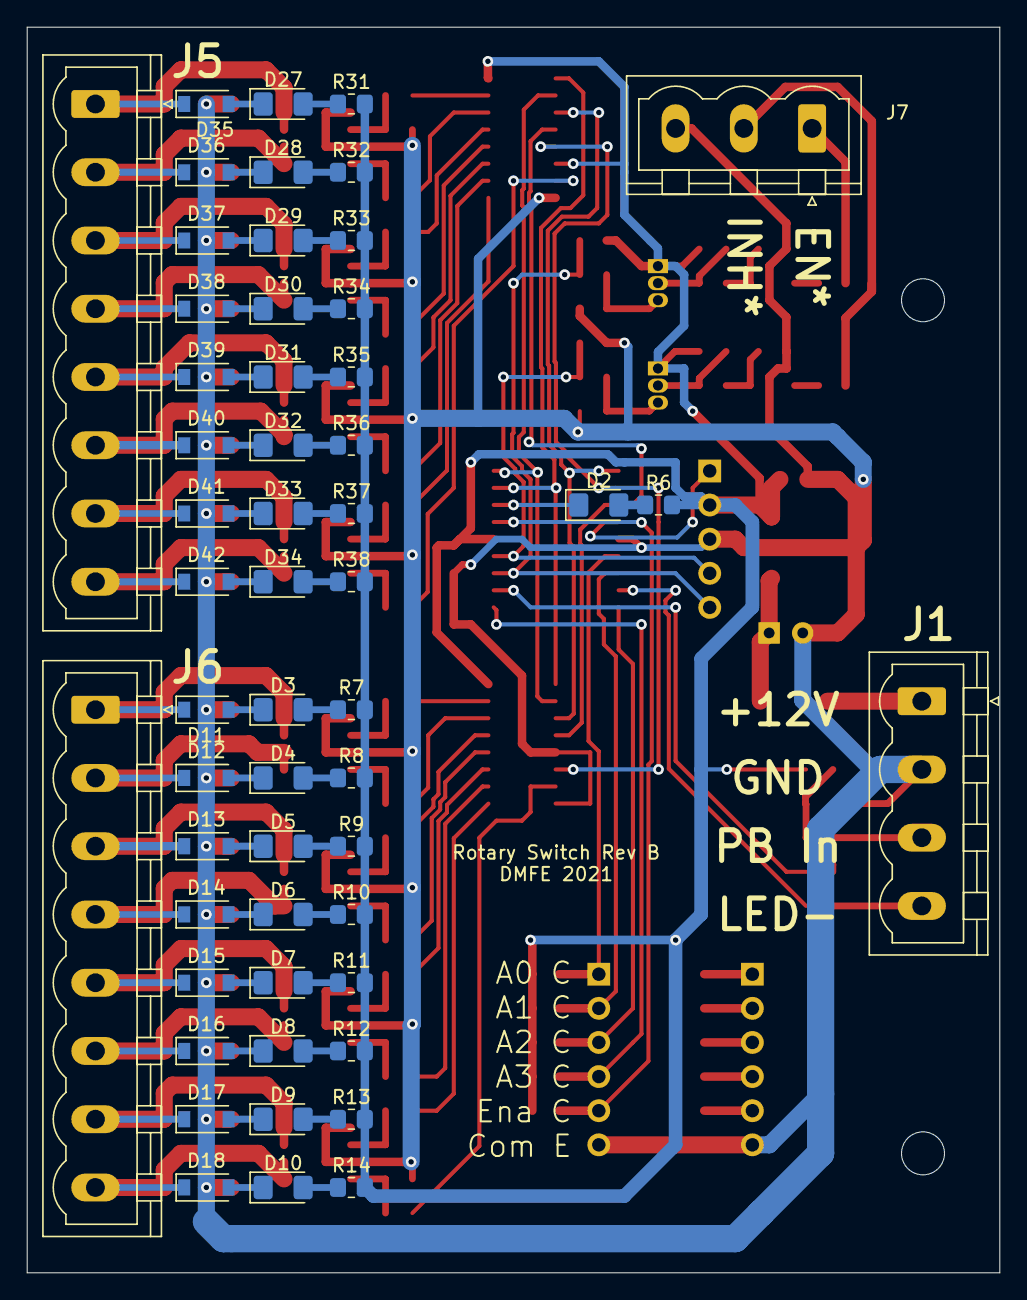
[picture p35: board R_Switch.kicad_pcb from below]

Board: 2 copper layers, 72.4 x 92.7 mm, 156 parts (54 on the bottom side), 119 nets.

Other parts of the board:
H1, H2: MountingHole_3.2mm_M3
