DavidMFlynn/RotarySwitch/(commit log)

2019-07-25 Enable and inhibit inputs
    [R_Switch.kicad_pcb, R_Switch.sch]
2019-08-07 14 stops
    [R-Switch.scad, RS_Bot.stl, RS_CW14.stl, RS_Knob.stl, RS_NP14.stl, RS_Retainer.stl, RS_Spacer.stl, RS_Top.stl]
2019-08-19 magnet detents
    [CW16Mag.stl, DetentMagHolder.stl, PointerKnob.stl, R-Switch.scad, SpacerRingMag.stl]
2019-12-07 Ordered Rev A
    [CW16.stl, CW16Mag.stl, DetentMagHolder.stl, R-Switch.scad, RS_Spacer.stl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]
2021-05-07 Rev B PCB (Smaller)
    [R_Switch-B_Cu.gbr, R_Switch-B_Mask.gbr, R_Switch-B_Silkscreen.gbr, R_Switch-Edge_Cuts.gbr, R_Switch-F_Cu.gbr, R_Switch-F_Mask.gbr, R_Switch-F_Silkscreen.gbr, R_Switch.drl]
2021-05-11 n7 and n9
    [BotPlate.stl, CodeWheel.stl, Cover.stl, DetentCover.stl, Knob.stl, NumberPlate.stl, R-Switch.scad, Spacer.stl]
2021-05-18 more n's
    [BotPlate.stl, CodeWheel.stl, CodeWheel8.stl, Knob.stl, KnobNS.stl, NumberPlate.stl, NumberPlate77.stl, NumberPlate8.stl]
